ColouredCat/CanSat/README.md

# CanSat

Code, CAD and Documentation for the 2025-2026 CanSat Project, also including old resorces from the previous year.
