ColouredCat/CanSat/CAD/cansat.png

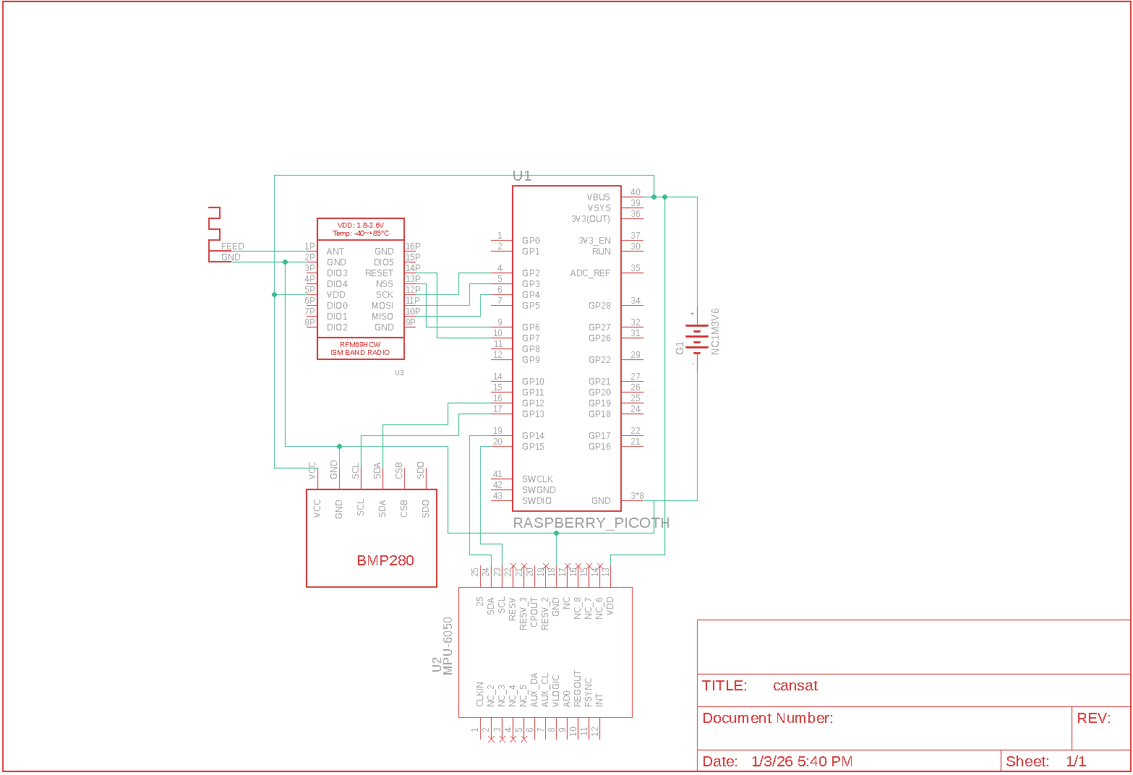
CAD/cansat.png
