ColouredCat/CanSat/Code/Flowcharts/PDR.png

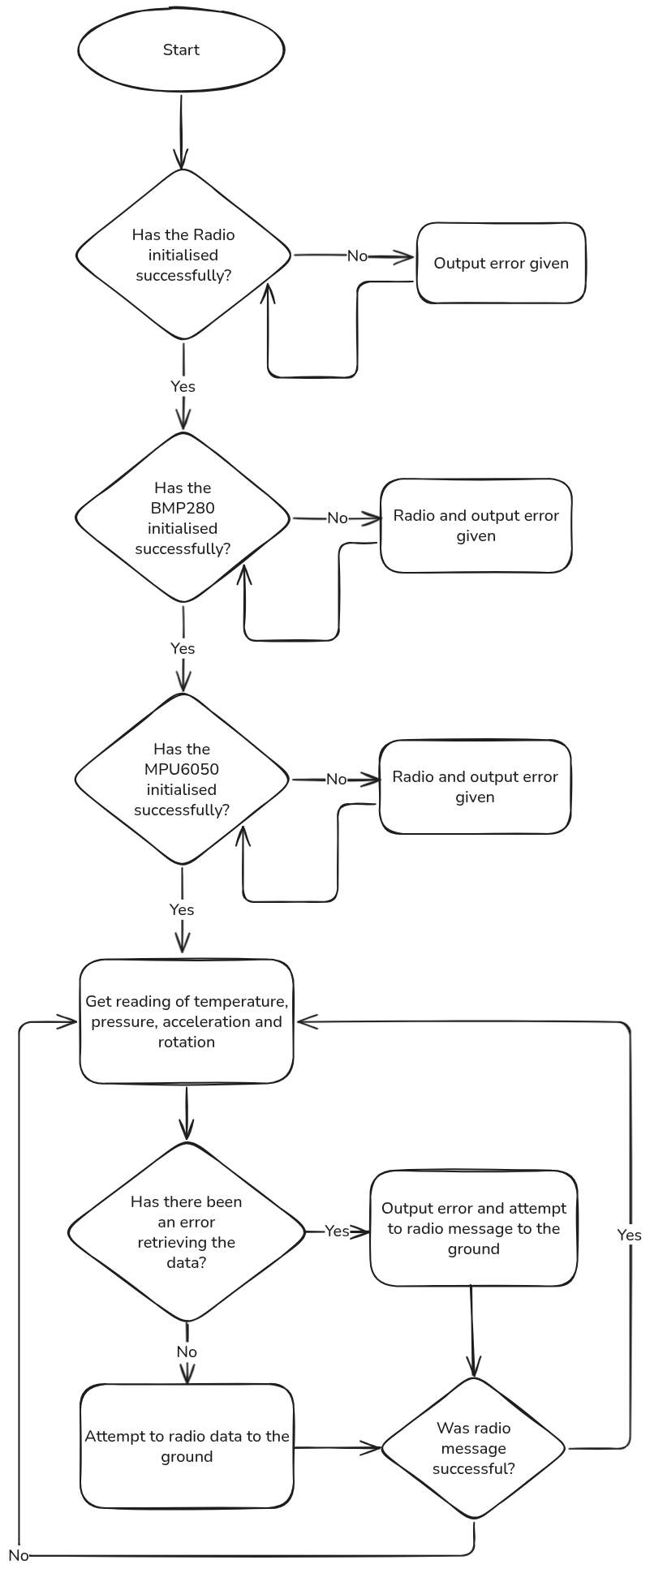
Code/Flowcharts/PDR.png
