ColouredCat/CanSat/CAD/CanSat - Body.stl

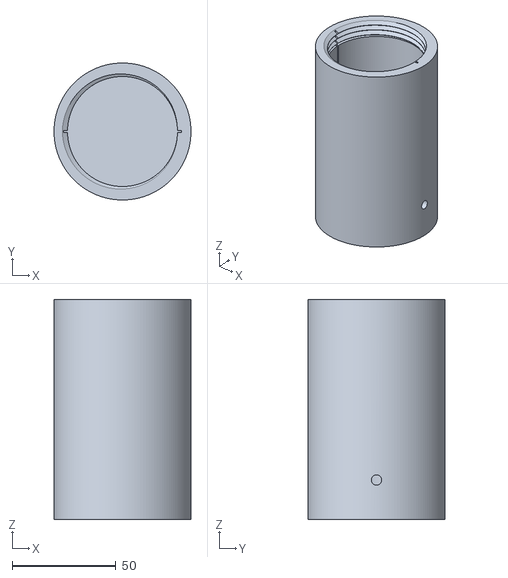
[picture p66: CAD file, 2026-01-24]
CAD/CanSat - Body.stl
66.0 x 66.0 x 106.0
