ColouredCat/CanSat/CAD/FreeCAD/CanSat.FCStd

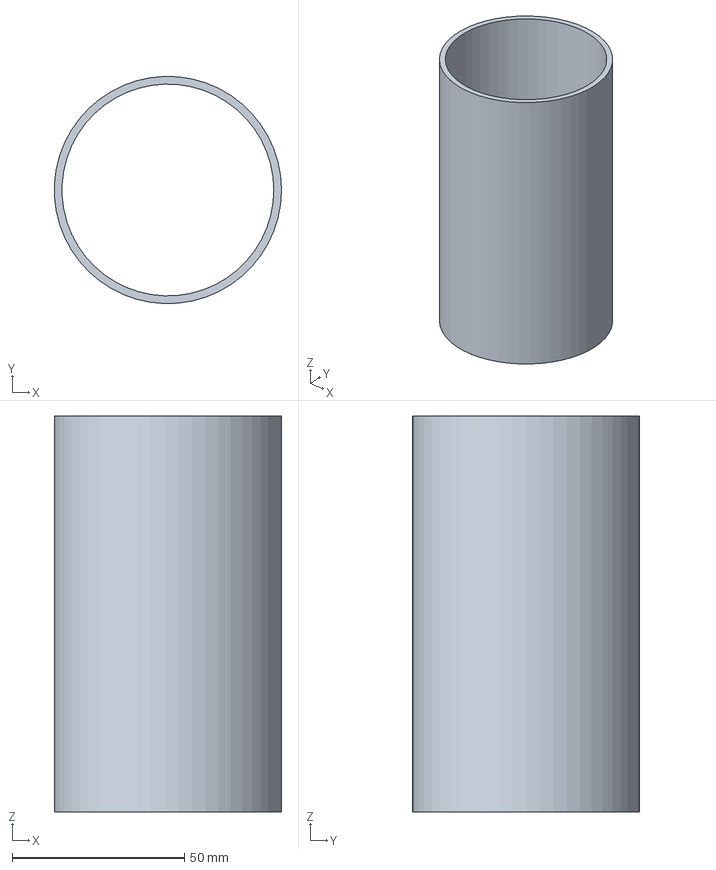
[picture p67: CAD file, 2025-02-06]
CAD/FreeCAD/CanSat.FCStd
65.9 x 66.0 x 115.0 mm
