ColouredCat/CanSat/CAD/CanSat - Lid.stl

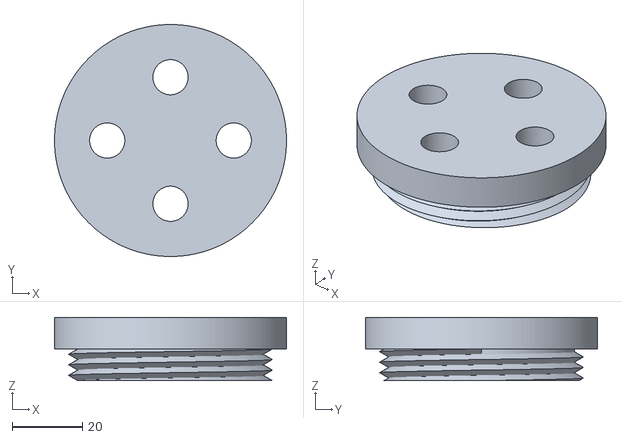
[picture p68: CAD file, 2026-01-24]
CAD/CanSat - Lid.stl
66.0 x 66.0 x 18.0
