ColouredCat/CanSat/CAD/FreeCAD/CanSat2.FCStd

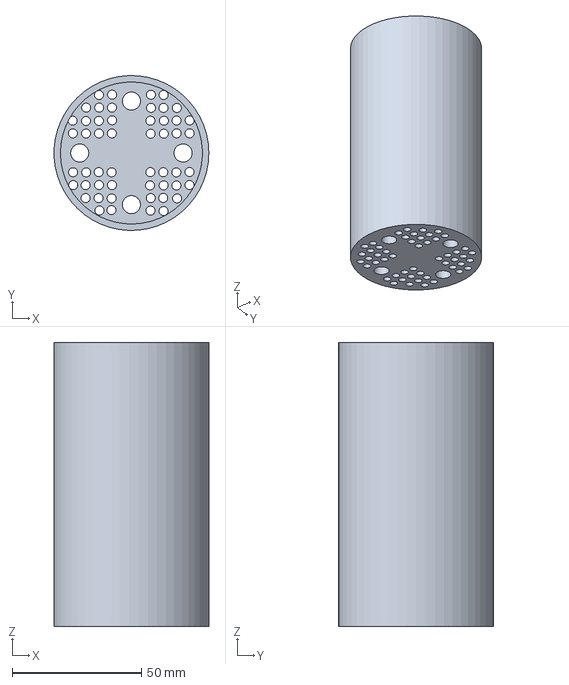
[picture p69: CAD file, 2025-02-06]
CAD/FreeCAD/CanSat2.FCStd
59.9 x 60.0 x 110.0 mm
