ColouredCat/CanSat/CAD/CadFinal.stl

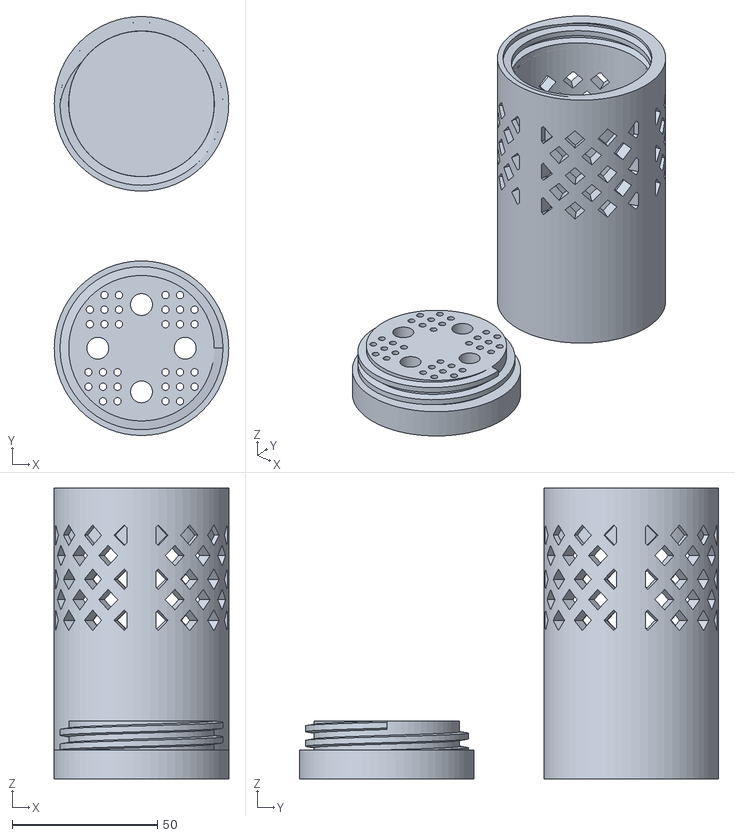
[picture p70: CAD file, 2025-02-06]
CAD/CadFinal.stl
60.0 x 144.0 x 100.0
