ColouredCat/CanSat/(list of files, cad)

Other CAD files:
Archive24-25/CAD/CadFinal.obj
CAD/CadFinal.obj
