ColouredCat/CanSat/(commit log)

2025-02-06 Upload files to ''
    [CadFinal.obj, CadFinal.stl]
2025-02-06 added tree
    [CadFinal.obj, CadFinal.stl, CanSat.FCStd, CanSat2.FCStd]
2025-02-16 Added non gui version of ground station
2025-02-16 Tweaked ground station code
2025-03-02 Added first test log for data handling
    [practice.xlsx]
2025-10-26 Reorganised tree to participate again 2025-2026
    [CadFinal.obj, CadFinal.stl, CanSat.FCStd, CanSat2.FCStd, practice.xlsx]
2025-11-17 Added flowcharts
2025-12-20 Added circuit diagrams
    [cansat.sch]
2026-01-24 Completed circuit diagrams and started working on data analysis
    [logT.csv]
2026-01-24 Added final flowcharts and CAD
    [CanSat - Body.stl, CanSat - Lid.stl]
2026-01-24 Added data handling
    [log.csv, pressure.csv, temp.csv]
2026-01-24 Removed archives
    [CadFinal.obj, CadFinal.stl, CanSat.FCStd, CanSat2.FCStd, practice.xlsx]
2026-01-24 Revert "Removed archives"
    This reverts commit 961d94c09be7ea6eec36c297075280e5f764480e.
    [CadFinal.obj, CadFinal.stl, CanSat.FCStd, CanSat2.FCStd, practice.xlsx]
2026-01-25 Remove temperature and pressure plots
    Removed temperature and pressure plots from analysis.
